SanWuCN/Driverless-bicycle/docs/STATUS.md

# 项目状态与路线图

更新时间：2026-10-10。

## 本轮已烧录、待完整实车验证

- 已修复 `±8°` 失衡后 Axis 0 错误锁存导致无法自动恢复的问题：上电、失衡或控制中
  ODrive 故障会进入受控恢复，满足扶正/停稳条件后最多清错三次、请求闭环并重新稳定计时
  2 秒；上位机同时加入人工“清错并重新准备”入口和恢复状态标志。持续错误不会无限重试。
- 后轮 Axis 1 在上电且车辆扶正、静止时也会受控清错并重新请求闭环；上位机可区分
  “等待平衡启动”“Axis 1 无反馈”和“等待编码器首帧”，不再统一显示为“里程融合未就绪”。
- 已实现网页串口选择、默认 2 Hz 基础状态/按需 20 Hz 详细遥测，以及拖动即下发的
  `±15°` 转向滑块。界面按 `1° = 10 µs` 显示指令角，使用 140 ms 防抖和 latest-wins
  调度，底层 MCU 协议不变。
- 后轮前进/后退/停止与循环演示已把速度范围收窄到 `0.01…0.10 m/s`、默认
  `0.03 m/s`，并加入限加加速度 S 曲线；启动器支持 macOS/Windows，macOS arm64
  独立应用已在本机打包并验证本地 HTTP/API 与静态页面可启动。
- 已加入 Windows x64 PyInstaller 自动打包任务，GitHub Actions 产物为
  `BikeControlStation-Windows-x64.zip`；重复启动会复用现有控制站页面。
- 后轮演示直接使用 Axis 1 编码器位置增量计算里程，IMU 纵向加速度只用于打滑诊断；
  失去平衡许可、后轮反馈或命令保活时撤销输出。位置增量方向、`0.220 m/turn`系数、
  2 m/1 m 距离以及循环演示仍需要固定悬空、然后低速地面实测。
- 固件提交 `41ae09b` 已于 2026-10-10 通过 ST-Link 写入并由 `st-flash` 完成回读校验。
  软件复位后 ODrive USB 只读检查显示 Axis 0 为 CLOSED_LOOP，Axis/Encoder/Controller
  错误均为 `0x0`，电流限制仍为 48 A。烧录时 UART7 未连接，因此 Axis 1 自动恢复、
  新错误回执以及超过 8° 后扶正 2 秒自动恢复仍需固定悬空实测。

## 已完成并在实车上观察

- macOS + VS Code + CMake + Arm GCC 编译链路。
- ST-Link 四线 SWD 连接和固件烧录。
- UART7 115200 8N1 在线遥测与 CSV 记录。
- 上电后后轮默认零指令，不再无命令匀速转动。
- 扶正后自动启动：±3°、角速度 ≤1°/s、连续 2 秒。
- 动态零点估计已应用于控制，学习轮速门槛 15 tps，范围 ±1.5°。
- 实车观察：动量轮平均速度接近 0、能在零附近正负交替、零点不持续单向漂移。
- Flash 双扇区持久化写入和周期保存；已观察到序号 1、2 的成功保存，无错误标志。

## 已实现但仍需受控验证

- STM32 侧动量轮软命令上限已改为 `±35 tps`，常态显式加速度限制为 80 tps²；ODrive Axis 0 已于 2026-10-07 同步并持久化为 `vel_ramp_rate=120 tps²`、`current_lim=48 A`、`current_lim_margin=12 A`、`vel_limit=50 tps`、`requested_current_range=80 A`，回读无误；完整配置备份为 `hardware/odrive/backups/odrive-v3.6-56v-fw0.5.6-current48-margin12-range80-speed-envelope-20261007.json`。旧固件曾因 HSE 编译值错误使 `HAL_GetTick()` 约慢一倍；12 MHz 时钟修正后 MCU 时间和 500 Hz 控制周期已验证正确。
- 80/120 tps² 自适应加速度限制已于 2026-10-07 烧录并与 ODrive 同步：正常保持 80，只有横滚误差 ≥0.60°、角速度 ≥0.50°/s、仍向外倾倒且控制方向正确时临时提升至 120，开始回正立即退出；新增 `ACCEL_BOOST_120` 遥测。烧录后 8 秒静态联机复核中，157 个样本无加速度/速度/电流饱和、无 ODrive 错误，120 增强占比为 0%，符合静态不触发的预期。日志为 `logs/web_pid_tuning_20261007_154022.csv`。
- 已加入并于 2026-10-07 烧录动量轮 `25–35 tps` 平滑速度包络：仅削弱让实测轮速继续增大的加速度，制动/反转方向保留完整控制权；软命令上限为 `±35 tps`，ODrive `50 tps` 硬保护不变，新增 `SPEED_ENVELOPE` 遥测和上位机介入占比。烧录后 10 秒静态复核中轮速峰值 `1.74 tps`、电流峰值 `4.98 A`，无任何限幅、超时或 ODrive 故障，速度包络介入率为 0%。日志为 `logs/web_pid_tuning_20261007_155810.csv`。
- 针对 `bike_telemetry_20261007_160013.csv` 中“速度命令已停止增加，ODrive 仍以约 48 A 追赶远端目标”的过冲根因，Axis 0 固件已改为直接力矩控制：常态 ±80 tps² 映射为约 ±30 A，救车 ±120 tps² 映射为约 ±45 A；实际轮速 `12–20 tps` 之间只衰减继续向外加速的力矩，反向制动力矩不削弱。UART7 新增 MCU 电流/力矩请求和 `TORQUE_CONTROL` 标志。该版本于 2026-10-07 16:32 烧录并校验成功，UART7 新协议无畸形帧、零力矩输出正常；由于 Axis 0 仍有编码器错误，ODrive 保持 IDLE 和原 Velocity + Vel Ramp 配置，尚未进入力矩闭环或进行方向测试。
- 2026-10-07 最新只读在线状态与上一次 `48 A` 备份不一致：Axis 0 当前为 IDLE，`input_mode=2`、`current_lim=30 A`、`requested_current_range=60 A`、`vel_ramp_rate=50 tps²`，并报告 `axis_error=0x100 / encoder_error=0x2`。尚未清错或写配置；在解释该回退并恢复编码器正常状态前，不进行力矩闭环实车测试。
- 随后清错发现 Axis 0 因编码器未 ready 而产生 `UNKNOWN_PHASE_ESTIMATE`。在不保存的临时 CAN node ID 62 安全隔离下，以原配置 10 A 完成 Axis 0 编码器偏移校准；约 9 秒后回到 IDLE，`encoder.is_ready=true`，轴/电机/编码器/控制器错误全部为 0。当前仍保持 node ID 62、零力矩和 STM32 `ODRIVE_TIMEOUT`，不会自动启动；恢复 node ID 24 和首次直接力矩方向测试尚待单独授权。
- 直接力矩首次启动在30 A / 8 A配置下触发 `CURRENT_LIMIT_VIOLATION`；提高到运行时40 A / 8 A后，自动平衡启动阶段再次出现同一错误，锁存电流读数约47.2 A，并伴随电机机械“咔咔”声。安全脚本均在轮速建立前将输入置零、Axis 0退回IDLE并隔离到临时node ID 62。根据用户决定，直接力矩路线暂缓；ODrive已在隔离状态恢复为Velocity Control + Vel Ramp、零速度、30 A / 8 A、50 tps速度限制和50 tps²斜坡，错误全清且编码器ready。STM32已于2026-10-07 16:50恢复烧录最后实车可用的±35 tps、25–35 tps速度包络、80/120 tps²速度控制结构；写入校验成功，UART7确认力矩标志关闭、速度命令为0。当前仍保持node ID 62隔离，等待单独许可后恢复24。
- 2026-10-07 尝试配置 ODrive `current_lim=50 A`、`current_lim_margin=12 A`、`requested_current_range=80 A`；重启后硬件回读 `max_allowed_current` 仍只有 `60.75 A`，低于 `50+12=62 A` 保护阈值，因此未进行动力试验并立即回退。当前已重新持久化为已验证的 `current_lim=40 A`、`current_lim_margin=8 A`、`requested_current_range=60 A`，全部错误码为 0；回退备份为 `hardware/odrive/backups/odrive-v3.6-56v-fw0.5.6-current40-after-50a-range-check-20261007.json`。
- 随后按受控方案将 ODrive 持久化为 `current_lim=48 A`、`current_lim_margin=12 A`、`requested_current_range=80 A`，有效电流上限回读为 `48 A`，硬件 `max_allowed_current=60.75 A` 高于 `48+12=60 A` 故障阈值，全部错误码为 0。配置备份为 `hardware/odrive/backups/odrive-v3.6-56v-fw0.5.6-current48-margin12-range80-speed-envelope-20261007.json`。该组合的硬件剩余裕量仅 `0.75 A`，已通过静态验证，仍需悬空、逐级的人工扰动验证，不应立即进行极限推车。
- 运行中 IMU 硬超时或 ODrive 明确轴错误/退出闭环会撤销平衡控制；单纯 CAN 心跳/编码器反馈超时只冻结动态零点和轮速回正慢环，姿态快环继续工作。该逻辑已烧录，仍需受控故障注入验证。
- ODrive Axis 0 在安全扶正窗口内处于 IDLE 时，STM32 会请求重新进入闭环；不会打断校准状态。
- 角速度目标、误差、P/I/D 分项、原始速度目标和限幅后速度目标已加入 UART7 扩展遥测。
- 断电/复位后是否正确读取最新持久化零点。代码已实现启动扫描和回退，但尚未进行一次专门的受控复位验证。
- UART7 诊断固件与回环脚本在当前最终接线上的复测。
- Keil 工程已加入 `balance_monitor.c`、`uart7_bridge.c`、`zero_persistence.c`，并将固件 Flash 上限改为 1792 KiB；仍需在 Windows/ArmClang 环境实际编译验证。
- 已定位 MCU 时间约慢一倍的根因：实际 HSE 为 12 MHz，但 HAL/CMSIS 的部分编译单元沿用了 25 MHz 默认值，使 SysTick 重装值错误。公共 HAL 配置、CMSIS 系统文件、CMake 和 Keil 工程现已统一为 12 MHz；静态验证和烧录后主机时钟对比均通过。
- 已实现并烧录 UART7 在线 PID 调参：CRC16 命令、白名单、参数范围、后轮运行锁止、按环清理历史状态、读取和一键回退；参数仅驻留 RAM，遥测逐帧记录当前增益。固件还加入了 PE7 接收轮询兜底以及 `UART7_RX_SEEN/UART7_RX_OVERFLOW` 诊断标志。
- 2026-10-06 重新接线后 UART7 双向通信恢复，连续 `GET/SET/GET` 均成功，`UART7_RX_SEEN` 正常且无溢出。完成角速度环 Kp 第一轮在线对比：`-20` 过强、`-13` 过弱、`-18` 接近原始表现，`-16` 在当前固定悬空静态工况下最佳；当前 RAM 值为 `RATE_KP=-16`，复位后仍会恢复编译默认 `-20`。对比日志位于 `logs/`（不提交 Git）。
- 角速度环 D 项比较完成：在旧速度目标结构的 `RATE_KP=-16` 下，`RATE_KD=0` 与 `-4` 均比 `-2` 差；同时确认该结构约 99.7% 时间触发 STM32 速度斜率限制，使实际加速度接近 Bang-Bang。
- “PID 直接输出加速度、限幅后积分为速度”的新结构已经烧录并在固定悬空状态验证。60 秒默认参数试验中：横滚误差 RMS 约 `0.046°`、角速度 RMS `0.168°/s`、角速度误差 RMS `0.337°/s`、轮速均值 `-0.025 tps`，原始加速度 RMS `6.76 tps²`、峰值 `27.2 tps²`，速度/加速度饱和、ODrive 超时和故障均为 0。相比旧结构消除了约 99.7% 的持续斜率饱和。
- 新加速度结构下完成旧离散参数 `RATE_KP=-16/-18/-20/-22` 与 `RATE_KD=0/-1/-2` 在线比较；综合最优为 `RATE_KP=-20、RATE_KI=0、RATE_KD=-2`。复测 30 秒得到横滚误差 RMS `0.039°`、角速度 RMS `0.144°/s`、轮速 RMS `0.903 tps`、加速度需求 RMS `5.71 tps²`，无任何限幅和故障。随后 PID 已改为标准时间形式，等效的编译默认 D 参数为 `RATE_KD=-0.004`。
- 尝试为隔离角度环临时关闭轮速回正环时，动量轮在 15 秒内达到约 `-10.25 tps`，因此已恢复 `WHEEL_KP=0.04`；恢复后轮速重新回到零附近。后续角度环调参保留慢环，仅通过一致的外部横滚扰动比较恢复时间、超调和峰值加速度。
- 已修补可能导致运行数分钟后 HardFault 的 IMU 解析越界、UART8 overrun 恢复和 UART7 无限等待，并已烧录。旧固件曾两次出现动量轮与遥测同时停止、复位恢复；修正版仍需至少 30 分钟悬空耐久验证。

## 已实现的调参基础设施

- 角速度环已改为与 2 ms 周期无关的标准时间形式：积分为 `error * dt`，微分为 `delta(error) / dt`；加入积分限幅和输出饱和条件抗饱和。为保持现有 D 作用等效，编译默认 `RATE_KD` 从旧离散写法 `-2` 换算为标准写法 `-0.004`，`RATE_KP=-20`、`RATE_KI=0` 不变；该版本已烧录。
- 已加入细网格批量扫参工具和整批统一分析工具。计划先对 `RATE_KP=-18.0 ... -22.0` 以 `0.1` 间隔、每组 30 秒、重复 2 次采集；候选顺序使用固定种子打乱，每 5 组插入 `-20` 基准以测量时间漂移。整批结束前不逐组改变策略。
- 分析不使用拍脑袋的单一加权分数：先剔除故障/饱和组，再比较横滚误差、角速度误差、轮速和加速度四目标 Pareto 前沿。静态前沿候选之后再进入人工推车扰动试验。
- 当前已烧录固件使用标准时间形式 `RATE_KD=-0.004`，与旧离散写法 `-2` 的 D 作用等效。

## 最高优先级待办

1. 完整安全状态机：BOOT、WAIT_UPRIGHT、ARMED、FAULT、ESTOP 等明确状态。
2. 对 IMU 硬超时、CAN 反馈降级和 ODrive 明确故障处理做实车故障注入验证。
3. 动量轮加加速度和电流的执行器级硬限幅。
4. 在新版 STM32 安全固件验证后，启用 ODrive watchdog，使 MCU 通信中断时自动退出闭环。
5. 实体急停、电机动力隔离和故障复位流程。

## PID 调参阶段

必须按顺序推进：

1. 固定车架、车轮悬空，验证所有方向和限幅。
2. 角速度环。
3. 角度环。
4. 动量轮速度回正环。
5. PID 固定后再验证动态零点在不同胎压和地面下的表现。

每个阶段记录同样的阶跃/扰动、UART7 CSV、限幅触发、最大轮速、最大加速度和结构振动，不同时盲调三个环。

### 2026-10-06 粗调结果

- 角速度环采用标准时间尺度参数 `RATE_KP=-20、RATE_KI=0、RATE_KD=-0.004`；其中 `-0.004` 与旧 500 Hz 离散写法 `-2` 等效。
- 角度环比较了 `ANGLE_KP=-3/-4/-5/-6/-7`。`-7` 虽将静态横滚误差 RMS 降至约 `0.040°`，但角速度误差 RMS 和加速度 RMS 分别增至约 `0.467°/s`、`9.36 tps²`；粗调保留折中值 `ANGLE_KP=-5`。
- 角度阻尼比较了 `ANGLE_KD=-0.5/-1.0/-1.5/-2.0/-2.5`。`-2.0/-2.5` 明显过度；`-1.0` 控制量最低，`-1.5` 横滚 RMS 更低且无饱和。粗调保留 `ANGLE_KD=-1.5`，精调和扰动试验重点复核 `-1.0 ... -1.5`。
- 轮速回正比较了 `WHEEL_KP=0.02/0.04/0.06/0.08/0.10`；`0.06` 是该批横滚、角速度误差、轮速和加速度四目标中唯一的 Pareto 非劣点。90 秒复核中轮速持续正负穿零，无速度/加速度饱和、ODrive 超时或故障。
- 当前已验证的粗调参数为 `RATE=(-20,0,-0.004)`、`ANGLE=(-5,0,-1.5)`、`WHEEL=(0.06,0)`。恢复固件已将 `WHEEL_KP=0.06` 设为编译默认值，避免复位后回到未经本轮验证的 `0.04`。
- 2026-10-06 左向人工扰动中出现两次失稳；第二次轮速由约 `+39 tps` 反向至 `-41 tps`，速度命令在 `-50 tps` 限幅停留约 5 s，期间无 CAN/ODrive 故障。曾根据方程符号推导翻转轮速慢环方向并加入大扰动让位，但烧录后实车立即出现大幅周期振荡；这证明该符号推导与实物的 IMU/电机/反作用方向定义不符。该尝试已全部撤回，恢复版回到原轮速慢环方向，且未保留让位逻辑。后续扰动问题必须从执行器速度余量、加速度限幅和饱和恢复策略分析，不再改变已经实车验证的环路极性。
- 80 tps² 扰动试验中，第一次轻推在约 `0.48°` 峰值后自行恢复；第二次则在角度环要求过大横滚角速度后进入 `±80 tps²`、`±50 tps` 和 `±30 A` 交替饱和，最终需要人工拉回。为抑制大误差下的 Bang-Bang 过冲，角度环输出的目标横滚角速度已增加 `±5°/s` 限幅，并增加 `RATE_TARGET_SAT` 遥测标志。新固件已烧录；10 秒静态验证中目标角速度、速度和加速度饱和次数均为 0，相对动态零点的横滚误差 RMS 约 `0.160°`，角速度 RMS 约 `0.257°/s`。
- 倒车边界：原 `±12°` 保护已通过人工实车验证；随后按实车感受将阈值改为横滚相对当前控制零点 `±8°`，新固件已烧录且静态验证正常。超限时立即撤销平衡、清空控制器状态并请求 ODrive Axis 0 进入 IDLE。人工扶回 `±3°`且角速度小于 `1°/s` 后，重新进入闭环并稳定计时 2 秒后才恢复平衡。遥测使用 `FALL_DISARM`锁存标志。
- 暂不加入角度或轮速积分：90 秒三段横滚均值仅约 `0.033°/0.026°/0.027°`；轮速虽略偏负但持续正负交替，动态零点仍在同方向消除低频偏差。此时再加积分会与动态零点形成两个低频积分器，无法可靠归因且增加 windup 风险。
- `±8°` 固件的 90 秒人工扰动试验识别到 5 次推车事件，全部自行恢复。最严重一次横滚误差范围约 `-0.791° ... +0.640°`，角速度峰值 `4.43°/s`，轮速范围 `-14.70 ... +13.46 tps`，约 `6.68 s` 后稳定恢复。全程无速度饱和、无角速度目标饱和、无 CAN/ODrive 超时或故障、无跌倒触发；加速度限幅在 `22/1764` 个遥测样本中触发（约 `1.25%`），原始加速度需求峰值 `161.3 tps²`。日志为 `logs/fall8-robustness-20261006.csv`。
- 已新增 STM32 UART7 与 ODrive USB 共用 Mac 单调时钟的同步采集器 `tools/synchronized_balance_odrive_telemetry.py`。实机 20 Hz + 20 Hz 验证中，最近样本时差中位数约 `13 ms`、P95 约 `24 ms`，无 UART 解析或 ODrive 轮询错误。
- 40 A 同步扰动基线证明电流限制确实会在强扰动中介入：`Iq_setpoint` 达到 `±40 A`，`Iq_measured` 约 `-41.19 ... +41.48 A`。第三次强扰动的横滚误差达 `-4.55° ... +5.80°`、角速度峰值 `19.81°/s`、轮速 `-31.57 ... +24.91 tps`，同时出现加速度、电流和角速度目标限幅。同步日志为 `logs/sync-current40-robustness-20261006.csv`。
- Axis 0 电流上限曾受控提高到 `45 A`，但强扰动试验出现 `axis_error=0x40`、`motor_error=0x1000`（电流限制违规），实测 `Iq` 峰值约 `47.9 A`。该配置已立即回退并持久化为已验证的 `40 A`，随后在回退固件烧录后清除故障，Axis 0 已恢复闭环且所有错误码为 0。回退备份为 `hardware/odrive/backups/odrive-v3.6-56v-fw0.5.6-current40-after-45a-fault-20261006.json`。
- 曾试验性加入“大扰动时冻结轮速回正慢环”的恢复门控，实车在第二组扰动中进入持续振荡，横滚误差最终达 `+12.91°`并触发跌倒保护。该策略判定失败，已从源码完全撤回；恢复到前一版已通过 5 次推车的控制逻辑，回退固件已烧录并验证。故障清除后首个 10 秒存在轮速约 `39.5 tps` 的恢复瞬态；随后 15 秒静态遥测中横滚误差 RMS `0.060°`、角速度 RMS `0.141°/s`、轮速 `-1.74 ... +2.93 tps`，无任何饱和、超时或 ODrive 错误。失败日志为 `logs/sync-current45-recovery-robustness-retry-20261006.csv`，回退稳态日志为 `logs/rollback-current40-static-settle-20261006.csv`。

## 底层运动控制后续

- 后轮速度闭环与实车速度标定。
- 转向舵机中位、死区、机械极限和转角映射。
- 已加入并烧录默认关闭的转向第一阶段框架：UART7 舵机校准、航向 PID、Axis 1
  速度反馈、1 秒命令超时、限速回中、横滚降额和独立 `S` 遥测。复位后连续读取
  99 条转向遥测，模式保持 `DISABLED`、PWM 为 0、后轮约 0 tps，IMU、Axis 1 与原平衡
  自动启动均正常。舵机中位、正负方向和机械安全范围仍需前轮悬空实测后确认。
- 2026-10-07 已在源码中新增正式 `STEER ANGLE` 舵角模式：平衡状态下静止和行驶均可
  使用，范围 `±100 µs`；转向轨迹降为最大 `40 µs/s`、`80 µs/s²`。从 `+100 µs`
  回中执行 `+100 → -40 → 0 µs`，从 `-100 µs` 回中对称执行 `-100 → +40 → 0 µs`，
  越中点停留 `300 ms` 消除连杆回差。航向 PID 仍只在后轮运动时启用。该版本已于
  2026-10-07 17:14 通过 ST-Link 写入并校验；复位后连续遥测确认平衡已启动、IMU 与
  ODrive 反馈正常，Axis 0/1 全部错误为 0。随后完成静止 `+100 → 0 → -100 → 0 µs`
  实车测试：目标到达时间约 `2.9 s`，两侧回中均准确经过 `±40 µs` 反向越中并在
  `5.61 s` 回到中位；全过程最大横滚误差 `0.338°`、最大角速度 `0.905°/s`、最大
  动量轮速度 `10.87 tps`、最大加速度指令 `33.74 tps²`，无速度/加速度饱和、无失衡、
  无 ODrive 错误。日志为 `logs/angle_mode_100us_20261007_171654.csv`。
- 后续 `-150 µs` 保持实测确认该方向实际为右转而非左转；约 140 秒保持期间车身角度
  很小，但动量轮长期约 `-10 tps`，暴露出轮速回正环只有 P、没有 I 所造成的稳态误差。
  当前源码已将正式 `ANGLE` 范围扩为 `±150 µs`，方向定义为负值右转、正值左转，
  将完整行程放慢到约 8 秒，并把轮速回正环改为带秒单位积分、抗饱和的 PI。根据
  `+100/-100/-150 µs` 三组实测稳态轮速，增加右转 `-0.0039°/µs`、左转
  `-0.0034°/µs` 的不对称转向—平衡前馈；默认 `WHEEL_KI=0.003` 只负责修正剩余
  误差，用于在持续转向负载下把动量轮拉回 0。该修订已于 2026-10-07 17:31
  通过 ST-Link 写入并校验。随后完成静止左转 `+150 µs`（`1670 µs`）90 秒保持测试：
  约 `8.1 s` 到达目标，最大横滚误差 `0.418°`、最大动量轮速度 `8.23 tps`，没有
  速度/加速度/角速度目标饱和、失衡或通信超时。测试最后 20 秒动量轮平均速度
  `+0.14 tps`、平均绝对速度 `0.67 tps`，横滚误差平均绝对值 `0.034°`，已从原来的
  长期单向转动收敛到零速附近正负调整；退出后舵机已回到 `1520 µs`，动量轮回到
  `0 tps`。日志为 `logs/web_pid_tuning_20261007_173552.csv`。
- 静止平衡与行驶平衡的模式切换。
- 转向/车速对横滚目标的前馈与限制。
- 低速、高速、停车和倒地恢复策略。
- ODrive 温度遥测与长时间热保护试验（母线电压/电流、q 轴电流和错误状态已加入主机同步日志）。

## 上位机路线图

底层稳定后再推进：

1. 定义稳定的 STM32 ↔ 上位机消息协议和时间戳。
2. 加入轮速、转角、IMU、里程计数据同步。
3. 视觉/激光雷达驱动与外参标定。
4. 状态估计与定位。
5. 建图。
6. 全局路径规划与局部避障。
7. 将期望速度/曲率下发到底层，并由底层负责安全限幅和失联停车。

## 已知技术债务

- 部分旧源码为 GB18030/GBK 编码，且包含混合换行。
- `bike.ioc` 未完整表达后来手工加入的 UART7、I2C2、TIM2 配置。
- 修改时钟相关头文件或更换构建系统时，必须确认所有编译单元的 `HSE_VALUE` 均为 12000000，不能依赖 STM32F4 默认的 25000000。
- 历史代码变量名和注释中仍有 PWM/速度/加速度概念混用，后续应重构为带单位的命名。
- UART7 当前为阻塞式逐字节发送；20 Hz 下可工作，但未来高带宽遥测应改 DMA/环形缓冲。
- CAN 过滤器当前全通，安全版应只接受需要的节点和消息。
- Axis 0 命令/查询 500 Hz 可能需要结合 CAN 总线负载和 ODrive 实际处理能力优化。
- 加速度遥测来自速度命令差分，不是独立加速度传感器或严格限幅后的执行值。
- ODrive 厂家文本中的 120 A 是配置值，不是当前机构验证过的安全值。
- 2026-10-06 监控时 CH340、ST-Link、ODrive 曾随同一 USB Hub 一起重新枚举；应检查扩展坞、上行线和供电稳定性，避免将主机 USB 瞬断误判为控制器停机。
