SanWuCN/Driverless-bicycle/docs/INTERFACES.md

# 引脚、总线与协议接口

`bike.ioc` 来自较早的 CubeMX 工程，UART7、I2C2、TIM2 等后来由源码补充。因此发生冲突时，以当前 `Src/*.c`、`Inc/*.h` 和实车接线为准，不要只看 `.ioc`。

## 1. STM32 接口总表

| 功能 | 外设 | STM32 引脚 | 参数 | 对端 |
| --- | --- | --- | --- | --- |
| SWD 数据 | SYS_JTMS-SWDIO | PA13 | 3.3 V SWD | ST-Link SWDIO |
| SWD 时钟 | SYS_JTCK-SWCLK | PA14 | 建议从 1 MHz 调试 | ST-Link SWCLK |
| ODrive CAN 接收 | CAN2_RX | PB12 | 250 kbit/s | CAN 收发器 RX |
| ODrive CAN 发送 | CAN2_TX | PB13 | 250 kbit/s | CAN 收发器 TX |
| CH100 接收 | UART8_RX | PE0 | 460800 8N1 | CH100 TX |
| CH100 发送 | UART8_TX | PE1 | 460800 8N1 | CH100 RX |
| Mac 遥测发送 | UART7_TX | PE8 | 115200 8N1；默认 20 Hz CRC 紧凑帧 | USB-UART/BLE RX |
| Mac/上位机接收 | UART7_RX | PE7 | 115200 8N1 | USB-UART/BLE TX |
| 历史上位机串口 | USART6_TX | PG14 | 默认 115200 8N1 | 旧上位机接口 |
| 历史上位机串口 | USART6_RX | PG9 | 默认 115200 8N1 | 旧上位机接口 |
| 舵机 PWM | TIM2_CH3 | PA2 | 50 Hz，当前 580–980 µs | DS5180 信号线 |
| OLED 数据 | I2C2_SDA | PF0 | 100 kHz，7 位地址 0x3C | SSD1306 |
| OLED 时钟 | I2C2_SCL | PF1 | 100 kHz | SSD1306 |
| 红色 LED | GPIO output | PE11 | 推挽输出 | 板载 LED |
| 绿色 LED | GPIO output | PF14 | 推挽输出 | 板载 LED |
| 其他输出 | GPIO output | PF6 | 当前用途待确认 | 板载/扩展 |
| 按键 | GPIO input | PE4 | 源码中读取 | KEY0 |

## 2. CAN 与 ODriveSimple

### 物理与位时序

- 外设：CAN2。
- APB1 时钟：42 MHz。
- Prescaler：12。
- BS1：12 TQ。
- BS2：1 TQ。
- SJW：1 TQ。
- 位率：`42 MHz / 12 / (1 + 12 + 1) = 250 kbit/s`。
- 标准 11 位 ID。
- 过滤器 Bank 14，当前使用全通掩码，由软件检查节点和命令。

CAN2 在 STM32F4 上与 CAN1 共享过滤器资源，所以初始化中同时打开 CAN1 时钟，并将 `SlaveStartFilterBank` 设为 14。

### 节点映射

| 逻辑轴 | ODrive 轴 | CAN node ID | 固件宏 | 功能 |
| --- | --- | --- | --- | --- |
| 0 | Axis 0 | 24 / `0x18` | `AXIS0_CAN_NODE_ID` | 动量轮 |
| 1 | Axis 1 | 16 / `0x10` | `AXIS1_CAN_NODE_ID` | 后轮 |

ODriveSimple 标准帧 ID：

```text
can_id = (node_id << 5) | command_id
```

当前使用：

- `Set_Input_Vel`：发送 8 字节数据，前 4 字节为 little-endian `float` 速度，单位 turns/s；后 4 字节为零。
- `Get_Encoder_Estimates`：远程帧请求，收到的后 4 字节为 little-endian `float` 速度估计。
- Axis 0 每 2 ms 发送速度命令并请求速度反馈。
- Axis 1 每 40 ms 发送一次速度命令；当前后轮默认指令为 0。
- 速度反馈使用最近 3 个样本的移动平均。

### 方向约定

方向与实车安装有关。当前源码包含以下符号约定：

- 动量轮速度命令：`odrive.set_speed0` 直接发送到 Axis 0。
- 后轮速度命令：发送时使用 `-odrive.set_speed1`。
- `drive_control`把正前进速度换算为负的`set_speed1`，发送处再取反；上电状态为停止，
  不允许自行匀速转动。

更换相线、编码器方向、IMU 安装方向或电机安装方向后，必须重新进行悬空、固定车架的方向验证。

## 3. UART8：CH100

- PE0：RX。
- PE1：TX。
- 460800 baud，8N1，无硬件流控，16 倍过采样。
- RXNE 中断逐字节送入 `packet_decode()`。
- 解码结果来自 `id0x91`：欧拉角 `eul[]` 和角速度 `gyr[]`。
- 当前横滚映射：`roll = eul[1]`，`roll_rate = gyr[0]`。

注意：接口只要持续保留旧值，看起来仍“有数据”；因此安全状态机必须按最后有效帧时间判断新鲜度，而不能只检查数值是否有限。当前自动启动做了 100 ms 新鲜度检查，但运行中超时停机尚待完成。

## 4. UART7：Mac 与遥测

- PE8：TX。
- PE7：RX。
- 115200 baud，8N1，无硬件流控。
- 正式固件默认每500 ms只输出一条46字节CRC基础状态帧（约92 byte/s），不包含IMU角度
  或角速度。收到`TELEM,LIVE`后才输出65字节/20 Hz平衡帧和34字节/约3.3 Hz转向帧。
- `TELEM,BASIC`返回低带宽模式；`TELEM,FULL`只供有线USB-UART诊断。复位后默认BASIC。
- UART7 不是 STM32F427 ROM bootloader 支持的下载口，只能用于业务通信/遥测。
- 使用 ROM 串口下载时应改接 USART1 或 USART3，并正确控制 BOOT0；当前实车更推荐 ST-Link SWD。

只看遥测时可只接 `PE8 -> 转接器 RX` 和 GND。若进行回环诊断，再交叉连接 TX/RX 并刷入诊断构建。

## 5. 舵机 PWM

TIM2 输入时钟 84 MHz：

```text
Prescaler = 84 - 1  -> 1 MHz 计数，即 1 µs/计数
Period    = 20000-1 -> 20 ms，即 50 Hz
Channel   = 3       -> PA2
```

`servo_set_duty(duty)` 的参数是相对中心的整数偏移：

```text
pulse_us = clamp(1520 + duty, 1370, 1670)
```

源码 `servo_init()` 的旧注释写着 PA0，但初始化和 PWM 输出实际均为 TIM2_CH3 / PA2。

只有收到带 CRC 的 UART7 `STEER` 命令后才开始输出 PWM。实车确认中位为
`1520 µs`，底层机械保护范围为 `1370–1670 µs`；正式 `ANGLE` 模式使用
`1520 ± 150 µs`。实车方向为：负偏移/较小脉宽右转，正偏移/较大脉宽左转。
所有正常转向经过最大 `20 µs/s`、`40 µs/s²` 的速度/加速度轨迹限制，完整
150 µs行程约8秒。3秒内未收到命令或`STEER,KEEP`保活会慢速回中；KEEP不返回回执，
避免无线链路被周期性确认包占满。

UART7 转向命令沿用 PID 在线调参的 CRC16 帧：

- `STEER,ANGLE,<offset_us>`：正式舵角模式，范围 `-150...+150 µs`；平衡状态下静止和
  行驶均可用。非零命令必须在 `±50...±150 µs` 且为 `5 µs` 的整数步进；`0` 为回中。
  回中命令会执行反向越中消隙轨迹。
- `STEER,HOLD,<heading_deg>`：行驶后的航向 PID；静止时由后轮速度门控禁止输出。
- `STEER,CAL,<offset_us>`：停驶标定模式，不作为正常控制接口。
- `STEER,DISABLE`：停止控制并慢速回中；从舵角模式退出时保留消隙回中轨迹。

```text
@P,<seq>,STEER,ANGLE,<offset_us>,<crc16> # 正式舵角模式，-150..150 µs
@P,<seq>,STEER,CAL,<offset_us>,<crc16>   # 停驶标定，-150..150 µs
@P,<seq>,STEER,HOLD,<heading_deg>,<crc16>
@P,<seq>,STEER,CAPTURE,<crc16>           # 捕获当前 IMU 航向
@P,<seq>,STEER,DISABLE,<crc16>           # 限速回中
@P,<seq>,STEER,KEEP,<crc16>              # 无回执保活
```

`CAL` 只允许后轮停止时使用。`HOLD` 即使收到命令，也只有在平衡已使能、IMU
新鲜、后轮处于运行状态且 Axis 1 反馈新鲜无故障时才会真正产生转向量。

## 5.1 后轮运动命令

Axis 1保持速度控制模式，STM32把网页的m/s换算为ODrive turns/s。当前沿用原项目标定值
`0.220 m/turn`，允许速度为`0.01…0.10 m/s`，默认`0.03 m/s`。正常启停使用
限加加速度的 S 曲线：加速上限 `0.025 m/s²`、减速上限 `0.05 m/s²`、加加速度上限
`0.10 m/s³`，避免低速指令仍以阶跃形式作用到轮胎：

```text
@P,<seq>,DRIVE,MANUAL,<signed_mps>,<crc16> # 正数前进，负数后退
@P,<seq>,DRIVE,DEMO,<mps>,<crc16>          # 启动循环演示
@P,<seq>,DRIVE,STOP,<crc16>                # 平滑停止，始终优先
@P,<seq>,DRIVE,KEEP,<crc16>                # 无回执保活
```

只有平衡已启动、Axis 1反馈新鲜且未触发倒车保护时才接受运动命令。3秒收不到KEEP、
安全条件丢失或编码器里程显示运动方向与命令相反超过0.10 m时，状态机撤销输出；演示模式
还会让转向回中。里程直接由 Axis 1 编码器的连续位置差累计，换算系数为
`0.220 m/turn`；单次位置跳变超过 `0.50 turn` 时丢弃该段增量并重新对齐，
防止反馈重置造成里程突跳。IMU X轴纵向加速度只用于打滑诊断，不再参与演示距离积分，
也不再作为启动演示的必要条件。

## 5.2 ODrive 故障恢复

ODrive 的 Axis/Motor/Encoder/Controller 错误由 ODrive 自身锁存；只复位 STM32 不一定会
清除。固件上电后或触发 `±8°` 失衡保护后，会在车体进入 `±3°`、横滚角速度不超过
`1°/s`、动量轮速度不超过 `2 tps`、后轮停止且反馈新鲜时执行受控恢复：保持零输出、
请求 Axis 0 进入 IDLE、最多发送三次 `Clear_Errors`，错误消失后请求 CLOSED_LOOP，
随后重新连续计时 2 秒才恢复平衡。错误持续存在时停止自动重试并保持禁止输出。

```text
@P,<seq>,ODRIVE,RECOVER,<crc16> # 人工重新发起上述受控恢复，不绕过安全条件
```

该命令仅在平衡未启动且后轮停止时接受，并会对 Axis 0 和 Axis 1 执行恢复。它不能修复
真实的过流、编码器、母线电压或接线故障；同一错误在三次清除后仍存在时，应读取具体
错误码并处理根因。

后轮命令不再统一返回含义模糊的 `DRIVE_UNSAFE_STATE`，而会返回具体原因：
`DRIVE_BALANCE_NOT_ARMED`、`DRIVE_AXIS1_NOT_READY`、
`DRIVE_FALL_RECOVERY_PENDING`、`DRIVE_ENCODER_FIRST_FRAME_PENDING`、
`DRIVE_ALREADY_ACTIVE` 或 `DRIVE_REAR_WHEEL_MOVING`。

## 6. I2C OLED

- I2C2：PF0 SDA、PF1 SCL。
- 100 kHz，开漏，上拉。
- SSD1306 7 位地址：`0x3C`。
- OLED 初始化目前在 `main.c` 中被注释，默认不参与运行。

## 7. 控制定时器与中断优先级

TIM3：

- 84 MHz 定时器时钟。
- Prescaler：`840 - 1`，得到 100 kHz。
- Period：`200 - 1`，得到 500 Hz / 2 ms 中断。
- 2 ms 中断中读取 IMU 状态、自动启动判断、平衡计算、ODrive CAN 命令与遥测快照。

主要中断优先级：

| 中断 | 抢占/子优先级 |
| --- | --- |
| CAN2 RX0 | 1 / 1 |
| UART8 | 1 / 1 |
| TIM3 | 1 / 3 |
| UART7 | 2 / 2 |

## 8. Flash 接口约束

固件映像最大区域为 `0x08000000–0x081BFFFF`。零点持久化占用 `0x081C0000–0x081FFFFF`。如果重新生成链接脚本、改变 MCU 型号、使用 CubeMX/Keil 默认散装文件或执行全片擦除，必须重新核对这两个区域，防止代码与数据重叠。
