SanWuCN/Driverless-bicycle/Src/main.c

/**
  ******************************************************************************
  * @file           : main.c
  * @brief          : Main program body
  ******************************************************************************
  * ... (版权声明保持不变) ...
  */
/* Includes ------------------------------------------------------------------*/
#include "main.h"
#include "stm32f4xx_hal.h"
#include "can.h"
#include "tim.h"
#include "i2c.h"
#include "usart.h"
#include "gpio.h"

/* USER CODE BEGIN Includes */
#include "odrive.h"
#include "imu.h"
#include "servo.h"
#include "task.h"
#include "upper.h"
#include "oled.h"
#include "key.h"
#include "balance_monitor.h"
#include "zero_persistence.h"
/* USER CODE END Includes */


/* USER CODE BEGIN PV */

/* USER CODE END PV */

void SystemClock_Config(void);

/* USER CODE BEGIN PFP */

/* USER CODE END PFP */

/* USER CODE BEGIN 0 */
int key_flag = 0;
int key_times = 0;
/* USER CODE END 0 */

/**
  * @brief  The application entry point.
  *
  * @retval None
*/
  
int main(void)
{ 
  /* MCU Configuration----------------------------------------------------------*/

  /* Reset of all peripherals, Initializes the Flash interface and the Systick. */
	
  HAL_Init();

  /* Configure the system clock */
  SystemClock_Config();

  /* Initialize all configured peripherals */
  MX_GPIO_Init();
  MX_CAN2_Init();
  MX_TIM3_Init();
	//MX_TIM4_Init();
	
  MX_I2C2_Init();
  MX_UART8_Init();
	MX_UART7_Init();
  /* USER CODE BEGIN 2 */
	
	odrive_init();
	imu_init();
	param_init(); // 初始化PID参数
	
	LL_USART_EnableIT_RXNE(UART8);
	LL_USART_EnableIT_RXNE(UART7);
	servo_init();
	
	// 开启定时器中断，控制循环开始运行
	HAL_TIM_Base_Start_IT(&htim3);
	
	HAL_Delay(1000); 
	//param.angular_zero = param.zer0 = -2;
	
	// 3. 开启平衡控制标志位
	//param.scope_flag = 1;

  /* USER CODE END 2 */
	//oled_init();
	key_init();
  /* Infinite loop */
  /* USER CODE BEGIN WHILE */
  
  while (1)
  {

  /* USER CODE END WHILE */

  /* USER CODE BEGIN 3 */

			BalanceTelemetry snapshot;
			balance_monitor_get_snapshot(&snapshot);
			zero_persistence_service(
				snapshot.zero_candidate_deg,
				(snapshot.flags & BALANCE_MONITOR_ZERO_LEARNING) != 0u);
			balance_telemetry_service();
		HAL_Delay(1);


	}
  /* USER CODE END 3 */

}

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
