SanWuCN/Driverless-bicycle/(commit log)

2026-10-07 Add portable bicycle control station and motion control infrastructure
    [odrive-v3.6-56v-fw0.5.6-accel80-20261006.json, odrive-v3.6-56v-fw0.5.6-before-tuning-20261006.json, odrive-v3.6-56v-fw0.5.6-current-before-watchdog-20261006.json, odrive-v3.6-56v-fw0.5.6-current40-accel80-20261006.json, odrive-v3.6-56v-fw0.5.6-current40-accel80-restored-20261007.json, odrive-v3.6-56v-fw0.5.6-current40-adaptive120-20261007.json, odrive-v3.6-56v-fw0.5.6-current40-after-45a-fault-20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]
2026-10-08 Refine low-speed drive and live steering controls
2026-10-08 Use rear encoder position for demo odometry
2026-10-08 Calibrate rear wheel distance scale
2026-10-10 Add safe ODrive recovery and precise drive diagnostics
